Arandu-CienciaLivre/Arandu-Stack-Macro-rail/firmware/README.md

# Firmware

[Português](#português) | [English](#english)

## Português

Esta pasta contém o firmware oficial do **Arandu Stack Macro Rail**.

O firmware é responsável pelo controle de movimento do trilho, interface com o usuário, configuração dos parâmetros de operação e automação das sequências fotográficas.

### Versão atual

**v1.0.0**

Esta versão corresponde à primeira versão estável publicada do firmware.

### Licença

O firmware é distribuído sob a **GNU General Public License v3.0 (GPL-3.0)**.

Copyright © 2026 Pedro José Vieira de Souza.

---

## English

This directory contains the official firmware for the **Arandu Stack Macro Rail**.

The firmware controls rail movement, the user interface, operating parameters, and automated photographic sequences.

### Current version

**v1.0.0**

This version corresponds to the first stable release of the firmware.

### License

The firmware is distributed under the **GNU General Public License v3.0 (GPL-3.0)**.

Copyright © 2026 Pedro José Vieira de Souza.
