Arandu-CienciaLivre/Arandu-Stack-Macro-rail/docs/electronics/images/arduino-nano-board.jpg

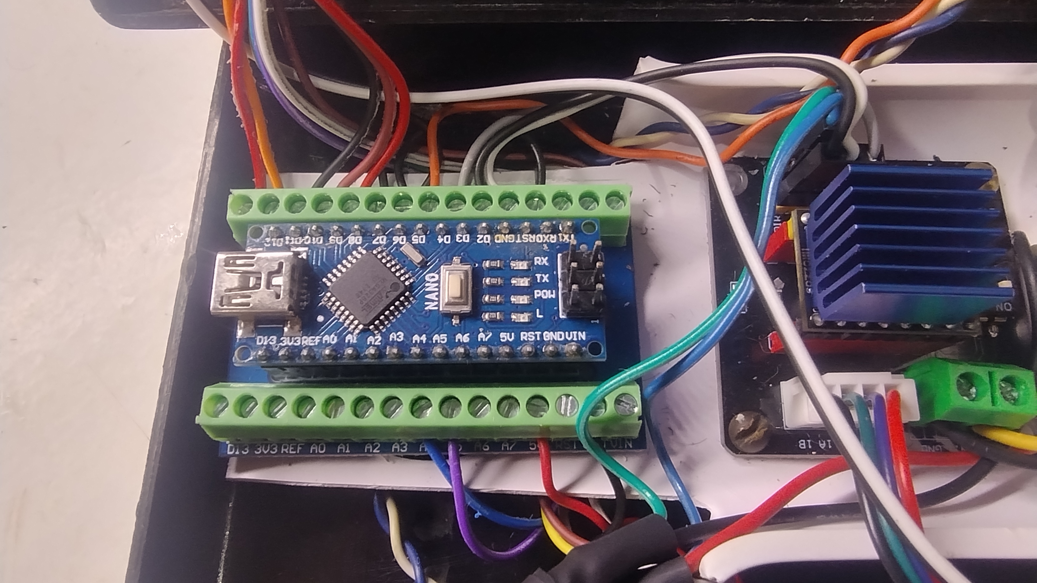
docs/electronics/images/arduino-nano-board.jpg
