Arandu-CienciaLivre/Arandu-Stack-Macro-rail/docs/electronics/images/control-panel.jpg

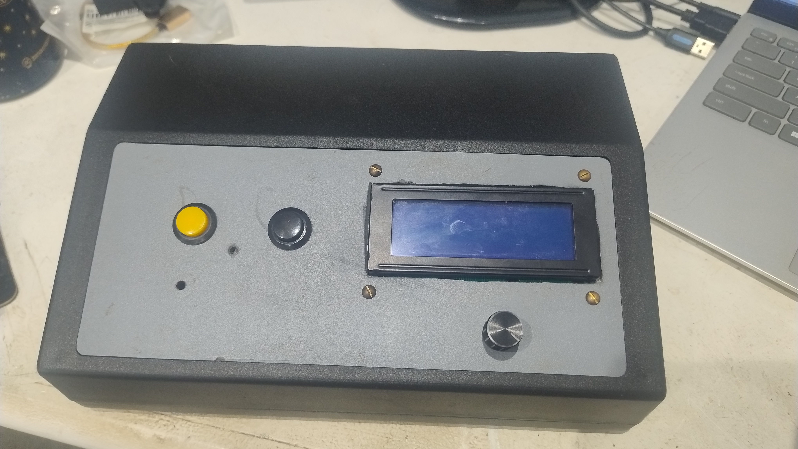
docs/electronics/images/control-panel.jpg
