Arandu-CienciaLivre/Arandu-Stack-Macro-rail/docs/electronics/images/eight-wire-cable.jpg

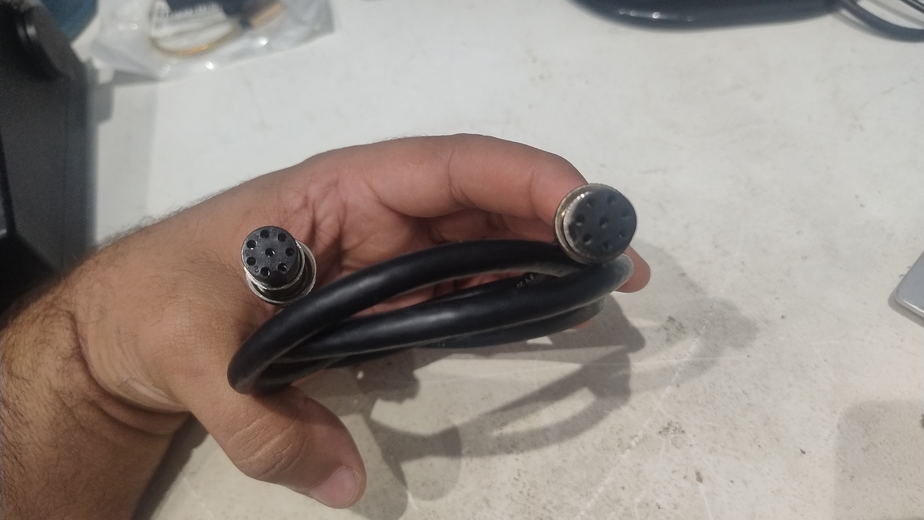
docs/electronics/images/eight-wire-cable.jpg
