Arandu-CienciaLivre/Arandu-Stack-Macro-rail/docs/electronics/images/electronics-overview.jpg

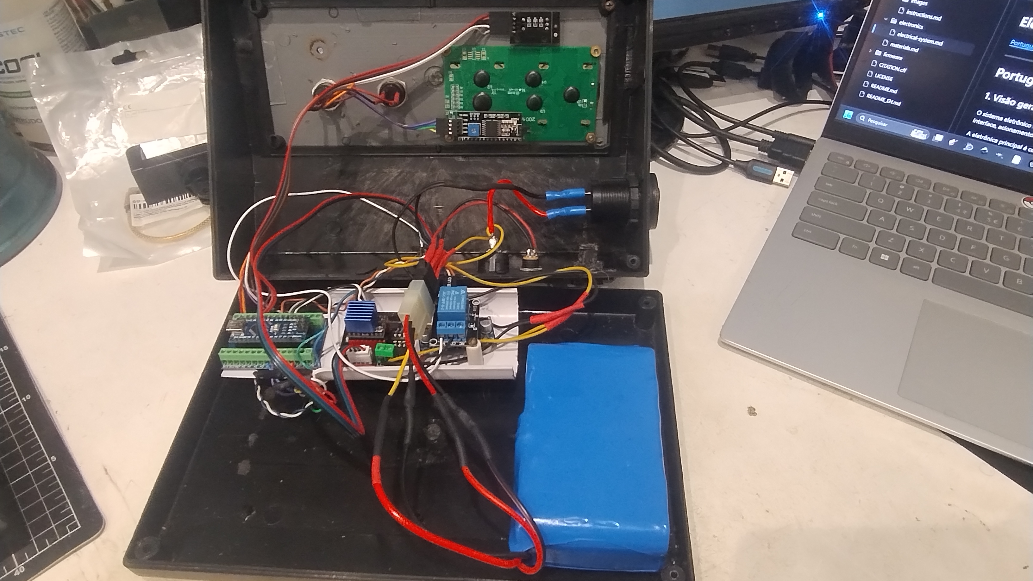
docs/electronics/images/electronics-overview.jpg
