Arandu-CienciaLivre/Arandu-Stack-Macro-rail/docs/electronics/images/rear-panel-connector.jpg

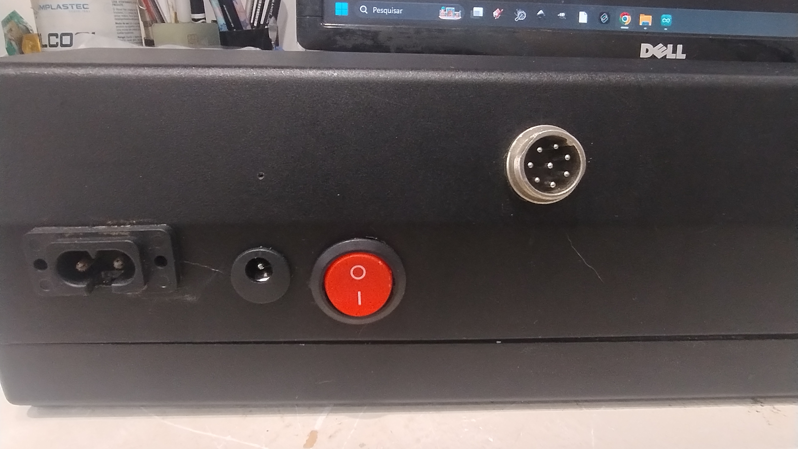
docs/electronics/images/rear-panel-connector.jpg
