Arandu-CienciaLivre/Arandu-Stack-Macro-rail/docs/electronics/images/rear-panel-connectors.jpg

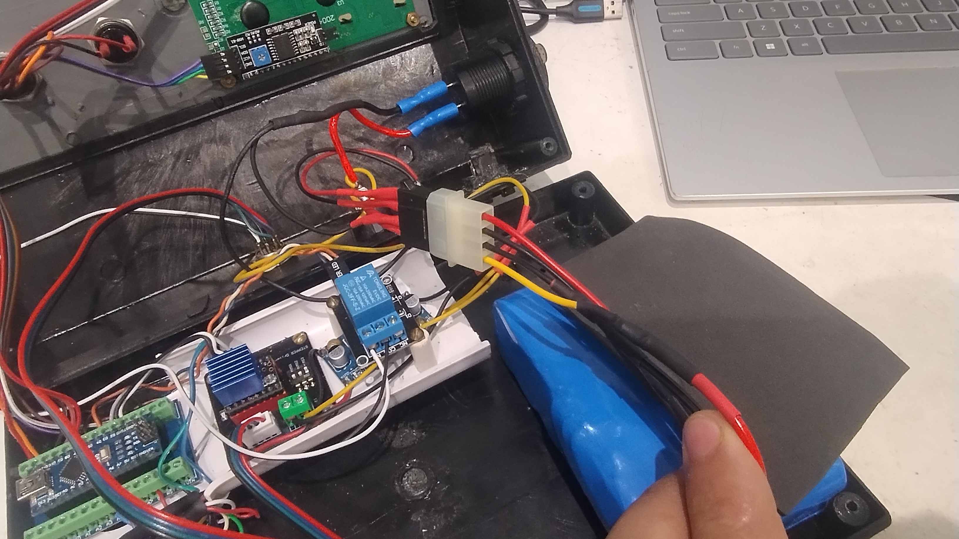
docs/electronics/images/rear-panel-connectors.jpg
