Arandu-CienciaLivre/Arandu-Stack-Macro-rail/docs/electronics/images/relay-power-regulator.jpg

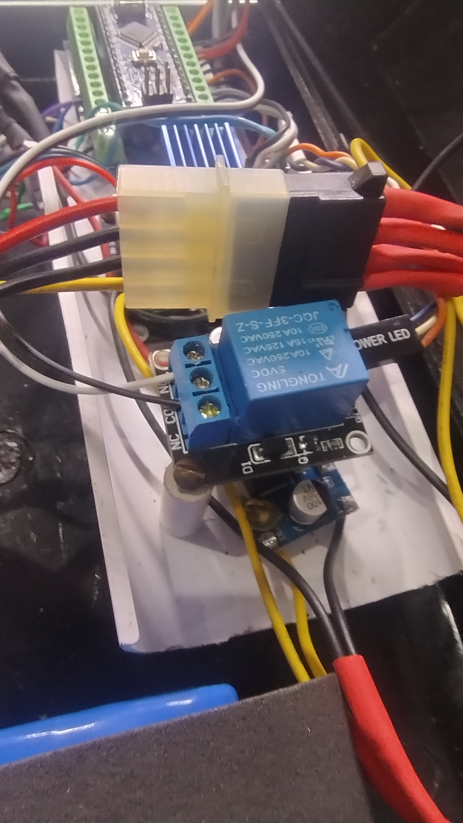
docs/electronics/images/relay-power-regulator.jpg
