Arandu-CienciaLivre/Arandu-Stack-Macro-rail/docs/electronics/images/tmc2209-driver.jpg

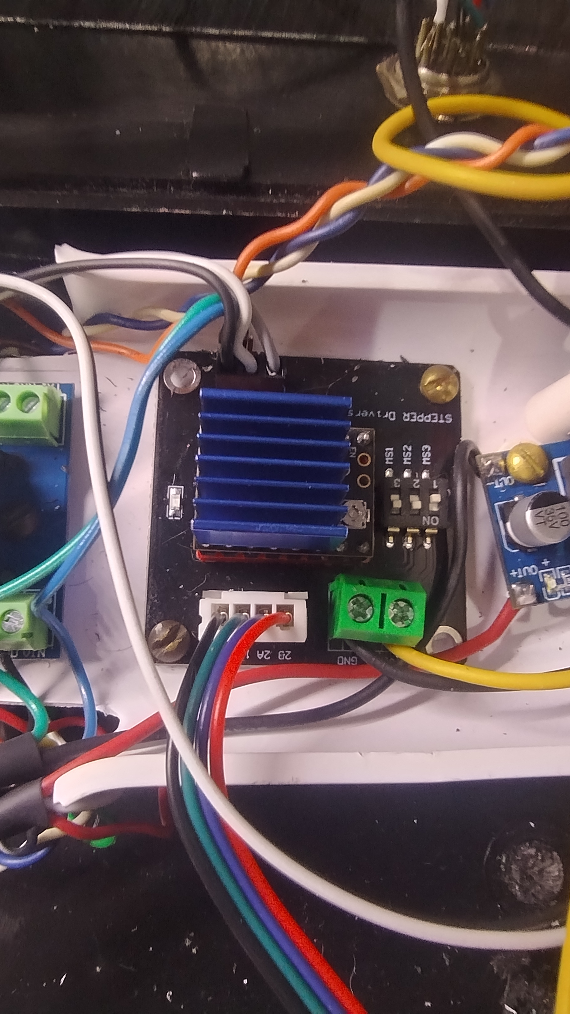
docs/electronics/images/tmc2209-driver.jpg
