Arandu-CienciaLivre/Arandu-Stack-Macro-rail/(commit log)

2026-08-30 Add Macro Rail firmware v1.0.0
2026-08-30 Add bill of materials
2026-08-30 Add mechanical assembly documentation
2026-08-30 Create assembly images directory
2026-08-30 Add assembly reference images
2026-08-30 Add images to mechanical assembly documentation
2026-08-31 Replace assembly images
2026-08-31 Correct motor mounting and alignment documentation
2026-08-31 Update mechanical assembly instruction
2026-08-31 Update electronics and wiring documentation
2026-08-31 Update materials list for v1.0.0 hardware
2026-08-31 Update motor driver comments for TMC2209
2026-08-31 Clarify rail power and camera shutter connections
2026-08-31 Update camera shutter and power connectors
