Arandu-CienciaLivre/Arandu-Stack-Macro-rail/(notices)

Notices in the files:
firmware/Arandu_Stack_Macro_Rail.ino:
modify it under the terms of the GNU General Public License
version 3 (GPL v3.0).
